S4-Lab/OpenPCB/README.md

# 💥OpenPCB: Manufacturing Double Layer PCBs Using Commodity Laser Engraver💥
This guide shows you how to manufacture a double layer PCB with vias and through holes using a relatively low cost (<$2k) commodity fiber laser engraver (ComMarker B4 20W). We provide custom enclosure design files to improve the safety of the engraver as well as 3D-printable clamp rigs to enable repeatable lasing operations on both sides of the PCB with minimal tuning.
## Video Guide:
<p align="center">
  <a href="https://www.youtube.com/watch?v=V7wXKYrV5ao">
    Video Guide
  </a>
</p>

## Equipment Needed:

<p align="center">
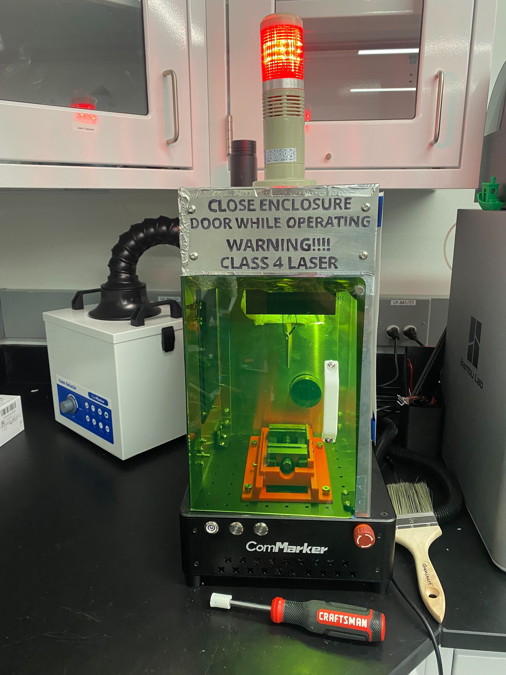
[picture p1: Images/Enclosure.jpg]
  
</p>

| Name | Description | Amount | Vendor |
| :---: | :---: | :---: | :---: |
| ComMarker B4 20W | Fiber laser engraver | 1 | [ComMarker](https://commarker.com/product/b4-laser-engraver/) |
| ComMarker Fume Extractor-100W | Extracts fumes from the enclosure | 1 | [ComMarker](https://commarker.com/product/commarker-fume-extractor-100w/) |
| 24V LED Strip | Illuminates the inside of the enclosure | 1 | [Amazon](https://www.amazon.com/dp/B0D8L9HJXN) |
| 24V Warning Light | Indicates the machine is on for general compliance purposes | 1 | [Amazon](https://www.amazon.com/dp/B06XKLY1N2) |
| UV Curing Light | UV light for curing soldermask ink | 1 | [Amazon](https://www.amazon.com/dp/B075GWKN83) |
| 1/16" Sheet Aluminum | Sheet metal for the enclosure | 1 | [McMaster-Carr](https://www.mcmaster.com/products/aluminum-extrusions/shape~sheet/multipurpose-6061-aluminum-sheets-and-bars-7/) |
| Self-Centering Vise | Vise for holding the PCB centered in the rig | 1 | [Amazon](https://www.amazon.com/dp/B0CKW946NN) |
| M5x6 mm Shoulder Bolts 5 pcs | Locating screws for the vise | 1 | [Amazon](https://www.amazon.com/dp/B077GX37SX) |
| Aluminum Tape | Tape for sealing around the enclosure to prevent light from exiting | 1 | [Amazon](https://www.amazon.com/Aluminum-Ductwork-Temperature-Insulation-Adhesive/dp/B0B6NDFXPN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)
| Safety Shield | Front door | 1 | [ComMarker](https://commarker.com/product/laser-engraver-enclosure-green/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)
| Metric Bolt Assortment | Use M5 for general assembly. M3 for hinges | 1 | [Amazon](https://www.amazon.com/dp/B0CF9HRPC8) 
| Neodymium Magnets | Door latching | 1 | [Amazon](https://www.amazon.com/dp/B0CF9HRPC8) |
| Trash Bag | Back opening sealer | 1 | [Amazon](https://www.amazon.com/Glad-ForceFlex-Kitchen-Pine-Sol-Original/dp/B0D6CWK6F9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) |

## Laser Engraving SOP
See the [Laser Engraver SOP Notion page](https://brave-paprika-311.notion.site/Laser-Engraver-SOP-2229387ccfca80dc991dc07f11edf8c1?source=copy_link) on how to fabricate your own PCBs!

## Credit
- [Stephen Hawes](https://youtu.be/wAiGCyZZq6w?feature=shared)
- [Electronoobs](https://youtu.be/PoYcjyghDx4?feature=shared)

This guide is brought to you by [Teresa Perez](https://www.linkedin.com/in/teresa23perez/) and [Bill Yen](https://billyen33.com)
