S4-Lab/OpenPCB/Images/Completed PCB.jpg

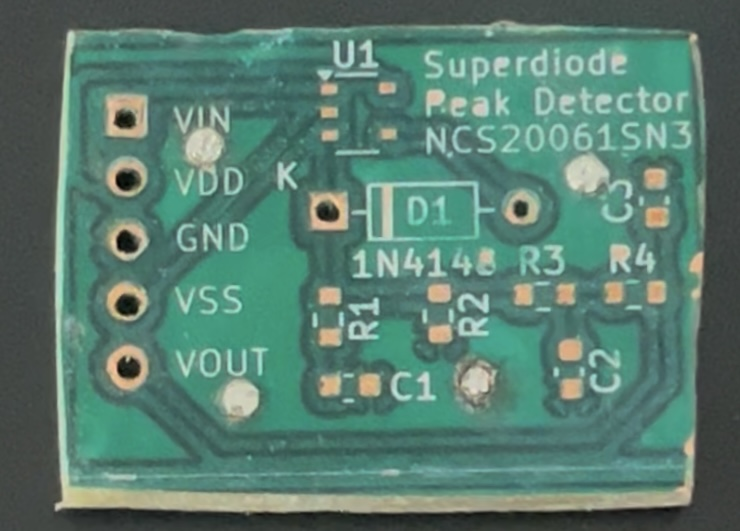
Images/Completed PCB.jpg
