S4-Lab/OpenPCB/Images/Engraving traces.jpeg

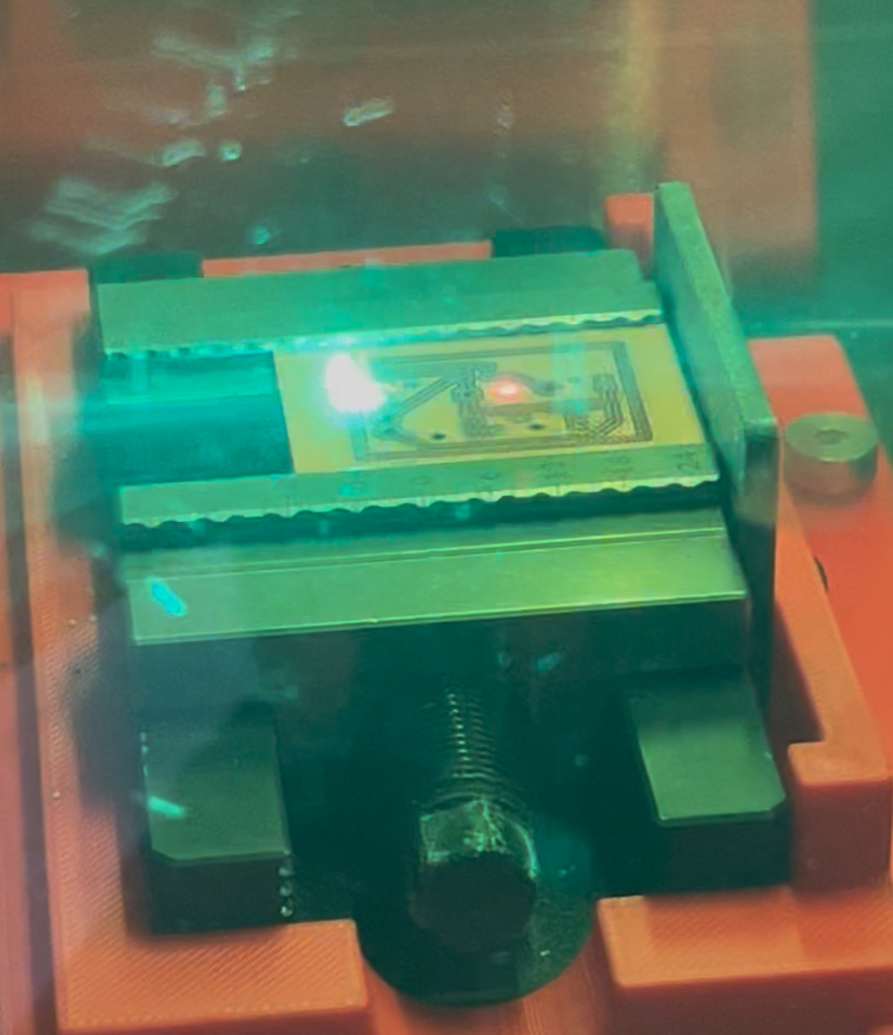
Images/Engraving traces.jpeg
