S4-Lab/OpenPCB/ExampleDesign/FlatCAM/Output/PeakDetector_Breakout-B_Cu.gbr_iso_combined.DXF

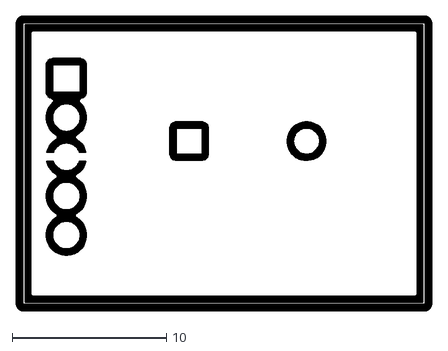
[picture p4: CAD file, 2025-07-15]
ExampleDesign/FlatCAM/Output/PeakDetector_Breakout-B_Cu.gbr_iso_combined.DXF
26.9 x 19.1
