S4-Lab/OpenPCB/ExampleDesign/KiCAD/PeakDetector_Breakout/PeakDetector_Breakout.kicad_pcb

## KiCad design ExampleDesign/KiCAD/PeakDetector_Breakout/PeakDetector_Breakout.kicad_pcb (2025-07-15)

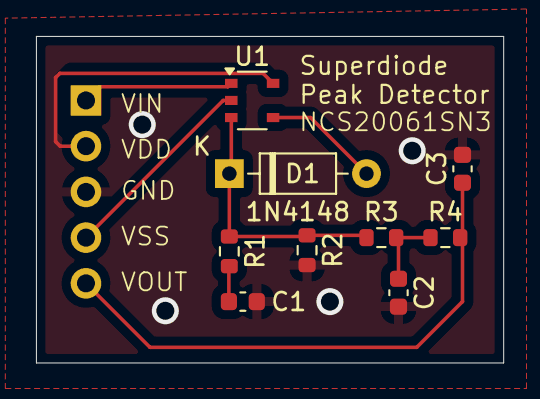
[picture p5: board PeakDetector_Breakout.kicad_pcb from above]

Board: 2 copper layers, 26.0 x 18.1 mm, 10 parts (1 on the bottom side), 9 nets.

Parts:
C1: c=220n; C_0603_1608Metric
C2, C3: c=100n; C_0603_1608Metric
D1: 1N4148; D_DO-35_SOD27_P7.62mm_Horizontal
J2: Conn_01x05_Pin; PinHeader_1x05_P2.54mm_Vertical
R1: r=100; R_0603_1608Metric
R2: r=332k; R_0603_1608Metric
R3, R4: r=100k; R_0603_1608Metric
U1: TSOP-5_1.65x3.05mm_P0.95mm

Connections:
0: C1.2, C2.2, C3.2, J2.3, R2.2
/VIN: J2.1, U1.1 (+)
/VOUT: C3.1, J2.5, R4.2
/V_peak: D1.1 (K), R1.1, R2.1, R3.1, U1.3 (-)
unnamed: C1.1, R1.2
unnamed: C2.1, R3.2, R4.1
unnamed: D1.2 (A), U1.4 (OUT)
VDD: J2.2, U1.5 (V+)
VSS: J2.4, U1.2 (V-)
